ghostinkoma/TinyWetherMemo/Docs/SOP8PinOut.txt

#CH32V003 PIN OUT

##1 -PD6/A6/URX/T2CH3_/UTX_
    -PA1/OSCI/A1/T1CH2/OPN0
  
##2 -VSS 

##3 -PA2/OSCO/A0/T1CH2N/OPP0/AETR2_

##4 -VDD

##5 -PC1/SDA/NSS/T2CH4_/T2CH1ETR_/T1BKIN_/URX_

##6 -PC2/SCL/URTS/T1BKIN
    -PC2/AETR_/T2CH2_/T1ETR_

##7 -PC4/A2/T1CH4/MCO/T1CH1CH2N_

##8 -PD4/A7/UCK/T2CH1ETR/OPO/T1CH4ETR_
   -PD5/A5/UTX/T2CH4_/URX
   -PC4/A2/T1CH4/MCO/T1CH1CH2N_
