ghostinkoma/TinyWetherMemo/host_esp32c3/Docs/ScreenShots/DarkMode/AS3935Settings_.jpg

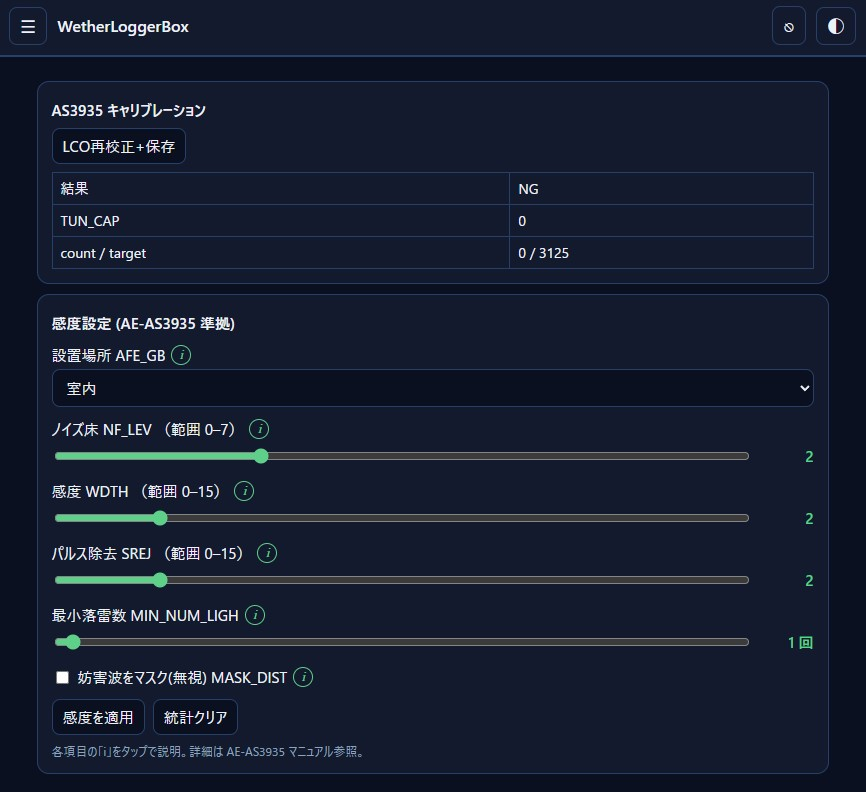
host_esp32c3/Docs/ScreenShots/DarkMode/AS3935Settings_.jpg
