ghostinkoma/TinyWetherMemo/host_esp32c3/Docs/ScreenShots/DarkMode/Chart_.jpg

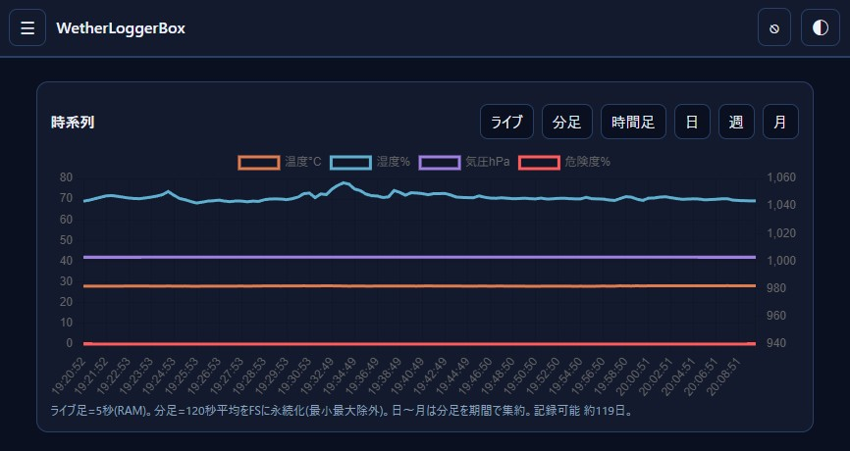
host_esp32c3/Docs/ScreenShots/DarkMode/Chart_.jpg
