ghostinkoma/TinyWetherMemo/host_esp32c3/Docs/ScreenShots/DarkMode/MesSettings_.jpg

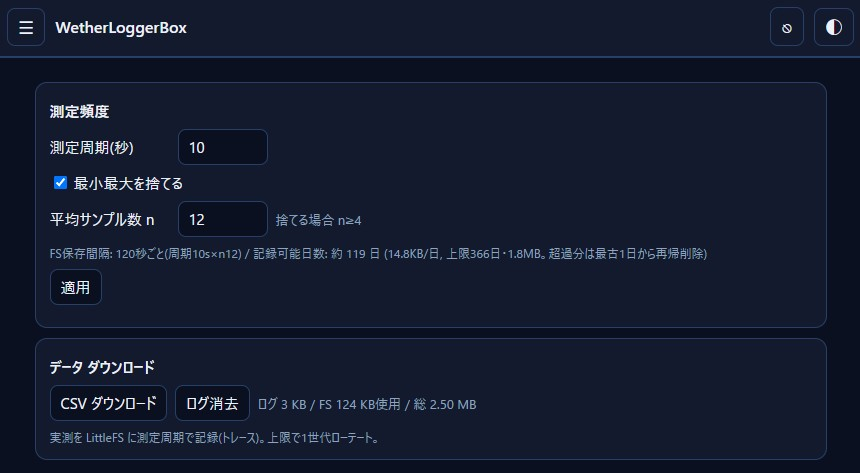
host_esp32c3/Docs/ScreenShots/DarkMode/MesSettings_.jpg
