ghostinkoma/TinyWetherMemo/host_esp32c3/Docs/ScreenShots/DarkMode/OffSets_.jpg

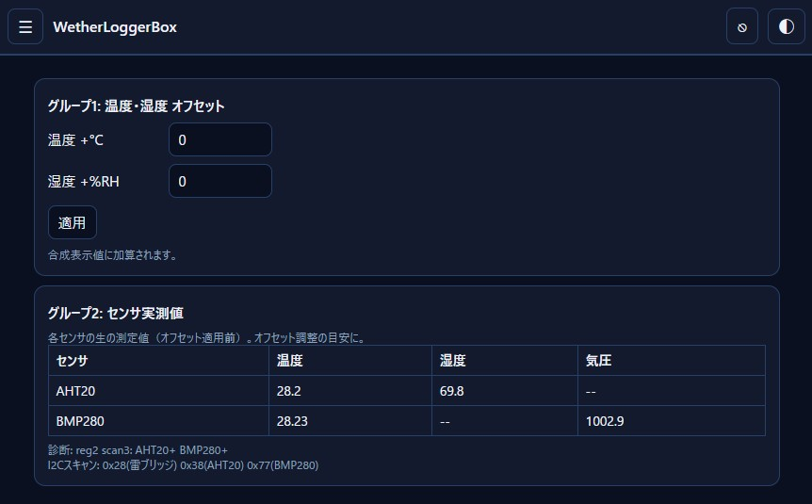
host_esp32c3/Docs/ScreenShots/DarkMode/OffSets_.jpg
