ghostinkoma/TinyWetherMemo/host_esp32c3/Docs/ScreenShots/DarkMode/Wifi_.jpg

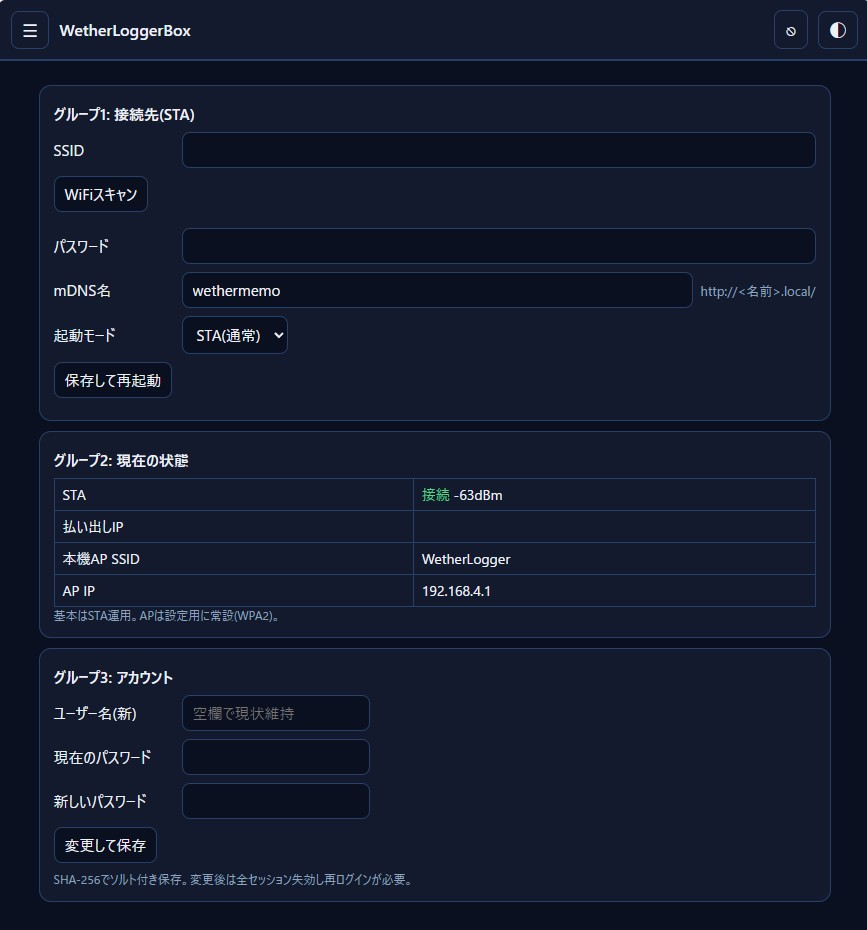
host_esp32c3/Docs/ScreenShots/DarkMode/Wifi_.jpg
