ghostinkoma/TinyWetherMemo/host_esp32c3/Docs/ScreenShots/LightMode/AS3935Settings.jpg

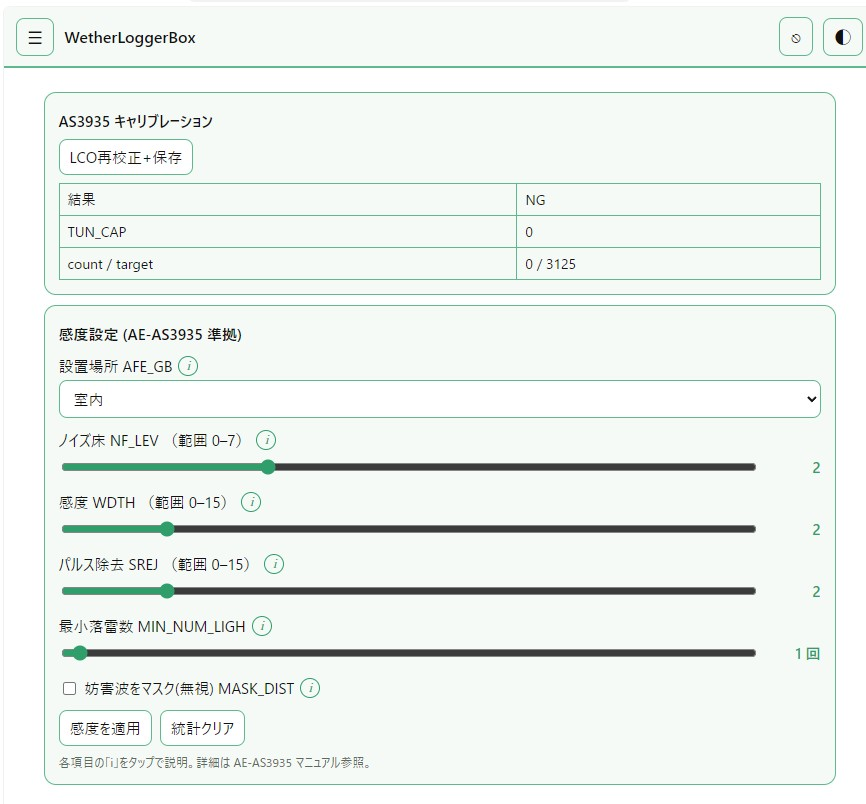
host_esp32c3/Docs/ScreenShots/LightMode/AS3935Settings.jpg
