ghostinkoma/TinyWetherMemo/host_esp32c3/Docs/ScreenShots/LightMode/Chart.jpg

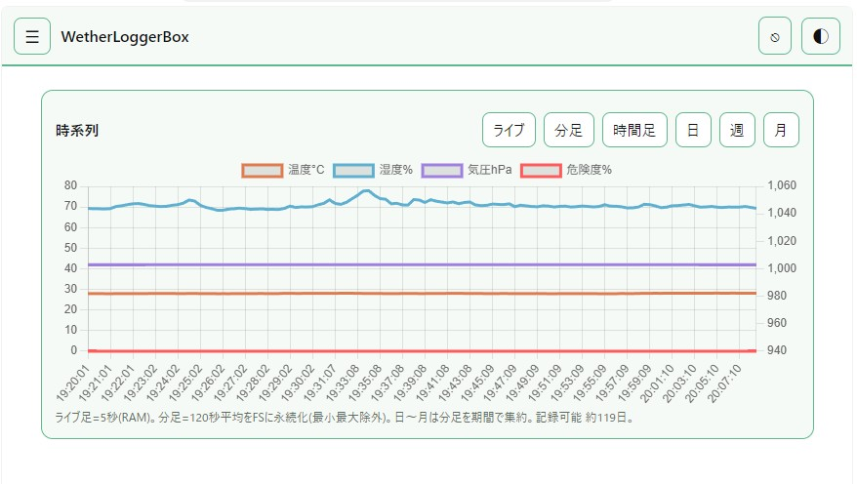
host_esp32c3/Docs/ScreenShots/LightMode/Chart.jpg
