ghostinkoma/TinyWetherMemo/host_esp32c3/Docs/ScreenShots/LightMode/Home.jpg

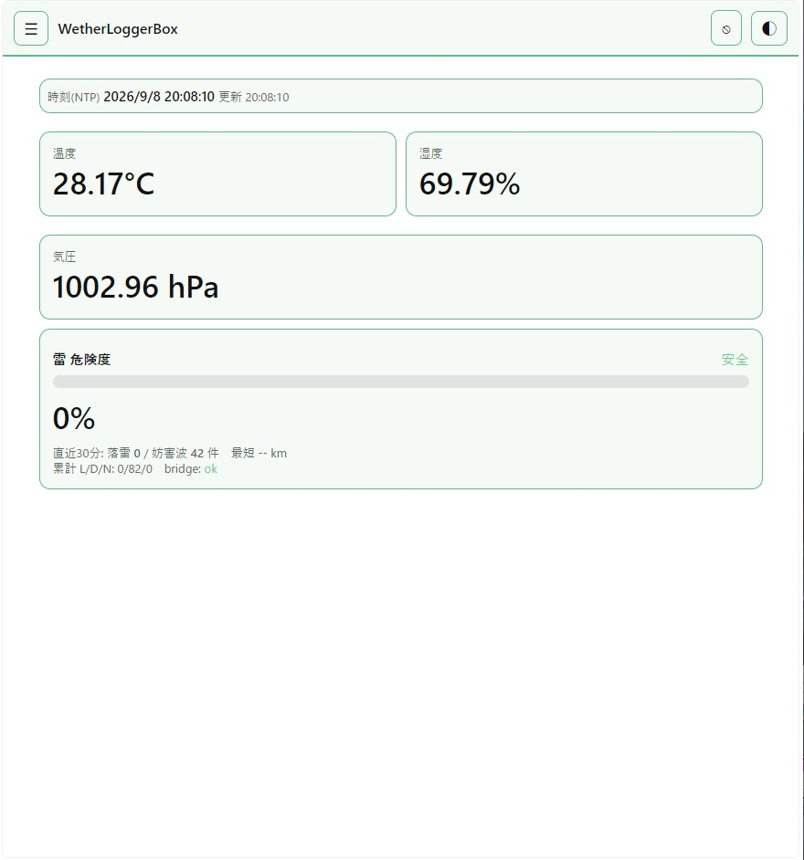
host_esp32c3/Docs/ScreenShots/LightMode/Home.jpg
