ghostinkoma/TinyWetherMemo/host_esp32c3/Docs/ScreenShots/LightMode/MesSettings.jpg

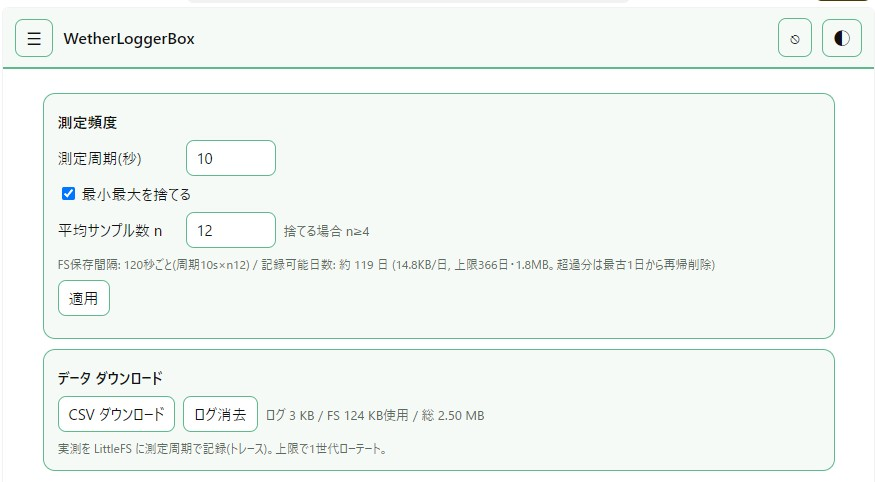
host_esp32c3/Docs/ScreenShots/LightMode/MesSettings.jpg
