ghostinkoma/TinyWetherMemo/host_esp32c3/Docs/ScreenShots/LightMode/OffSets.jpg

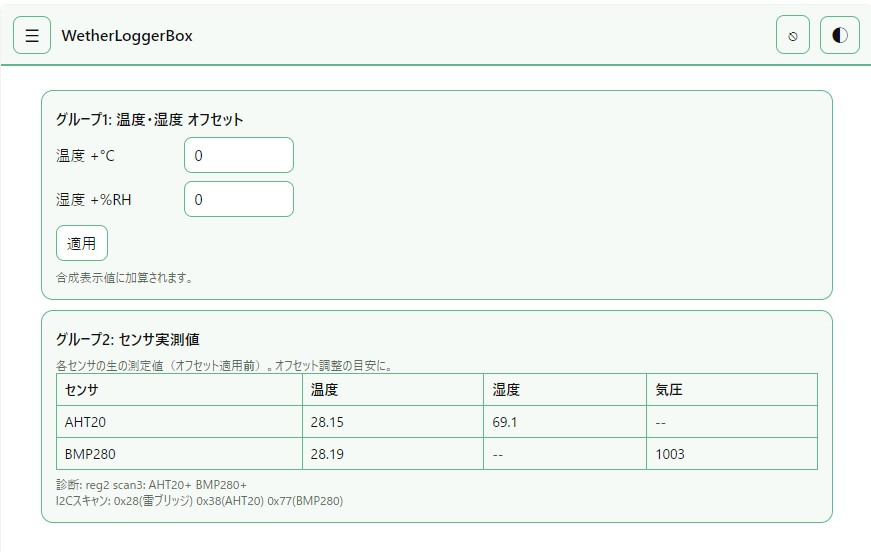
host_esp32c3/Docs/ScreenShots/LightMode/OffSets.jpg
