ghostinkoma/TinyWetherMemo/host_esp32c3/Docs/ScreenShots/LightMode/Wifi.jpg

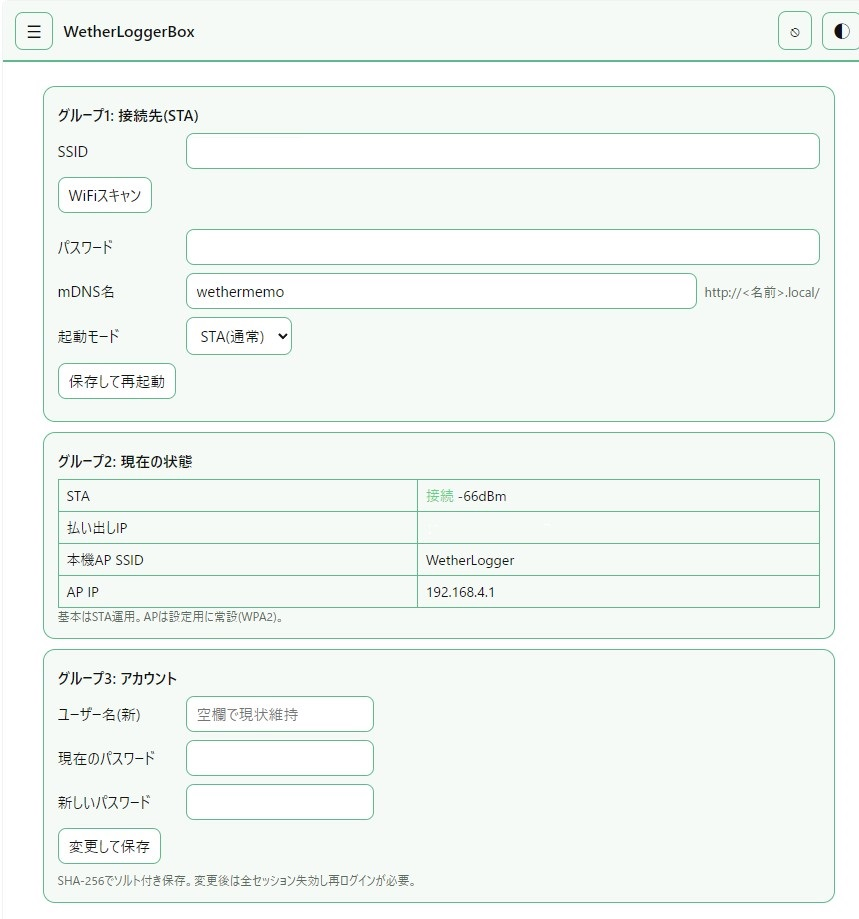
host_esp32c3/Docs/ScreenShots/LightMode/Wifi.jpg
