ghostinkoma/TinyWetherMemo/(commit log)

2026-09-08 Initial commit: ThunderSense AS3935->CH32V003 I2C bridge
    CH32V003 firmware (ch32fun/PlatformIO) + ESP32 host library + docs.
    - Event-driven AS3935 capture (EXTI L1-L4), absolute timestamps (SysTick + NTP)
    - Triple-buffer bundles, CRC16, non-destructive read + (gen,crc) CLEAR ack
    - Top-32-by-energy overflow policy, monotonic counters, fail-safe on sensor fault
    - Full host I2C control: AFE gain, noise floor, SREJ, calibration, register R/W
    - Flash-persisted LCO calibration (option bytes), IWDG, VDD health
    - Hardware-verified on the sensor side (SW-I2C, calibration, spark test: 81 disturbers)
    [ReadLightning.ino, ThunderSense.h, adc.c, adc.h, as3935.c, as3935.h, bundle.c, bundle.h]
2026-09-08 feat(host): ESP32-C3 WetherLoggerBox host app; non-commercial license; sanitize secrets
    [partitions.csv]
2026-09-12 feat: i18n(en/ja)+Home nav+chart fix; WiFi AP/STA exclusive; CH32 24MHz option; test log 2026-09-13
    host SPA: default-English i18n + Japanese toggle + Settings page; nav Home; chart keeps hidden series across Ajax refresh. WiFi: AP and STA mutually exclusive (STA->AP fallback). firmware: 24MHz(HSI) option documented, 48MHz kept default for stability. docs: Docs/TEST_LOG/WetherLoggerBox_2026-09-13.md (24/48MHz flash, clock A/B, spark test, WiFi-drop log retention) + UI screenshots. tools: gen_page_gz.ps1.
    [config.h, funconfig.h, main.cpp, web_ui.cpp, wifi_session.cpp, wifi_session.h]
2026-09-12 docs: English-first READMEs + non-commercial license refinements
    READMEs reorganized English-primary: README.md (EN) + README_JP.md (JP) for both top and host_esp32c3. Corrected stale notes (spark=noise not disturber; CH32 flash issue was a host LDO power fault not a v2.17 incompatibility; Chart.js is bundled locally=offline OK; 7 pages incl. Settings + Home nav; AP/STA mutually exclusive; 48MHz default). LICENSE: explicit fork/modify freedom (non-commercial), attribution (this repo URL + author 'ghostinkoma') required on any redistribution/fork, no warranty/no liability.
2026-09-12 docs: event-buffer & command-path architecture note (EN + JP)
    Adds Docs/EVENT_STORAGE_AND_COMMANDS.md (+_JP): analysis of whether the stored-event count (N_BINS) can grow and how it interacts with the command path. Findings: (1) N_BINS is capped at ~35 by the mem.h 640B ISR-stack reserve (N=40 is correctly build-blocked); (2) event bins and the command buffer are orthogonal - raising N_BINS does not starve commands; (3) the real command-drop risk is CMDBUF_DEPTH=1 (silent drop under concurrent load), independent of N_BINS. Decision: keep N_BINS=32. Also adds MAX_EVENT_COUNT config knob (=32, alias of N_BINS) as future groundwork with a host TS_MAX_EVENTS wire-contract note; links the note fr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
    [ThunderSense.h, config.h]
2026-09-13 LICENSE を更新
2026-09-13 chore: gitignore local DISPATCH.md (private handoff with device IP/MAC/creds)
